gorkaftv1/TFT-CAN-BLE-system/documentation/03_Resumen.tex

{\setlength{\parskip}{8mm}
{\huge{\textbf{Resumen}}}

    {\large{El presente Trabajo de Fin de Título aborda el diseño y desarrollo de un sistema de diagnóstico para vehículos basado en el bus CAN con acceso inalámbrico. Sobre una Raspberry Pi se implementa la pila de protocolos de diagnóstico del automóvil (ISO-TP, OBD-II y UDS), que permite consultar el estado del vehículo y sus códigos de avería en tiempo real. Esta sesión de diagnóstico se expone de forma inalámbrica mediante Bluetooth Low Energy, de modo que pueda monitorizarse desde una aplicación móvil multiplataforma, con persistencia de las sesiones para su análisis posterior. Con el fin de validar la solución de forma independiente del vehículo, se desarrolló además un simulador de unidad de control electrónica (ECU) sobre Arduino que reproduce el comportamiento de una centralita real. El sistema se verificó primero sobre este banco de pruebas y, posteriormente, sobre vehículos reales de distintos fabricantes, contrastando sus resultados con una herramienta de diagnóstico comercial. El trabajo demuestra la viabilidad de construir desde cero una herramienta de diagnóstico portable, de bajo coste y extensible, con un enfoque formativo orientado a la comprensión profunda de los protocolos de comunicación del automóvil.}}

\newpage

{\huge{\textbf{Abstract}}}

    {\large{This Final Degree Project addresses the design and development of a CAN-bus--based vehicle diagnostics system with wireless access. On a Raspberry Pi it implements the automotive diagnostics protocol stack (ISO-TP, OBD-II and UDS), enabling real-time access to the vehicle's status and its diagnostic trouble codes. This diagnostic session is exposed wirelessly over Bluetooth Low Energy so that it can be monitored from a cross-platform mobile application, with session persistence for later analysis. To validate the solution independently of the vehicle, an Electronic Control Unit (ECU) simulator was also developed on Arduino, reproducing the behaviour of a real control unit. The system was first verified on this test bench and later on real vehicles from different manufacturers, comparing its results against a commercial diagnostic tool. The work demonstrates the feasibility of building a portable, low-cost and extensible diagnostic tool from scratch, with an educational focus aimed at a deep understanding of vehicle communication protocols.}

}}
