gorkaftv1/TFT-CAN-BLE-system/documentation/07_Metodologia.tex

\section{Metodología de desarrollo}

El desarrollo de este trabajo se ha llevado a cabo siguiendo la metodología basada en la construcción iterativa de prototipos. Se seleccionó esta metodología dada la dinámica explorativa del proyecto.

La metodología basada en prototipos se estructura en cuatro fases principales: análisis de requisitos, diseño rápido y construcción del prototipo inicial, evaluación y refinamiento iterativo, junto con la documentación más la posterior presentación. Estas fases no son estrictamente secuenciales sino que admiten solapamiento parcial: en particular, las fases de construcción y evaluación se ejecutaron de forma alternada durante la mayor parte del desarrollo, con ciclos cortos de implementación seguidos de pruebas sobre el banco de ensayo Arduino.

\section{Fases y tareas}

\subsection{Fase 1 — Análisis de requisitos \textnormal{(50 horas estimadas)}}

Esta fase inicial se dedicó al estudio de los fundamentos técnicos necesarios para abordar el desarrollo del sistema.

\textbf{Tarea 1.1 — Estudio de la plataforma hardware.} Se analizaron las características de la Raspberry Pi como plataforma de ejecución de la herramienta de diagnóstico, incluyendo el soporte de la interfaz SocketCAN en Linux, la compatibilidad con el controlador CAN MCP2515 y las opciones disponibles para el servidor BLE. Asimismo, se evaluó el Arduino MKR como plataforma del simulador, estudiando la librería CAN disponible y sus capacidades de temporización.

\textbf{Tarea 1.2 — Estudio de los protocolos de comunicación CAN.} Se realizó un análisis detallado de los estándares ISO 11898 (CAN)~\cite{ISO11898-1:2024}, ISO 15765-2 (ISO-TP)~\cite{ISO15765-2:2016} y SAE J1979 (OBD-II)~\cite{SAEJ1979:2014}, prestando especial atención a la estructura de las tramas, los mecanismos de control de flujo y el formato de codificación de cada parámetro. Se revisaron asimismo los conceptos fundamentales de UDS (ISO 14229-1)~\cite{ISO14229-1:2020} y sus servicios más relevantes para la implementación también de las respuestas negativas.

\textbf{Tarea 1.3 — Estudio de Bluetooth Low Energy y librerías disponibles.} Se estudiaron los conceptos fundamentales de BLE GATT, el servicio Nordic UART Service (NUS) y las opciones de implementación disponibles en Python para la Raspberry Pi, evaluando las librerías \texttt{bleak}~\cite{Bleak_lib} y \texttt{bless}~\cite{Bless_lib}. En el lado de la aplicación móvil, se analizó la librería \texttt{react-native-ble-plx}~\cite{ReactNativeBLEPLX} y su compatibilidad con las características de escritura y notificación del servicio NUS.

\textbf{Tarea 1.4 — Análisis de herramientas software.} Se definió el conjunto de herramientas de desarrollo a utilizar: Python 3 con las librerías \texttt{python-can}~\cite{Twiss23-pythoncan} y \texttt{can-isotp}~\cite{Menager23-isotp} para la capa de transporte CAN, SQLite para la persistencia de datos, React Native con Expo~\cite{Expo_docs} para la aplicación móvil, y el IDE de Arduino~\cite{Arduino_IDE} para el simulador. Se estableció asimismo la estructura del repositorio y el flujo de trabajo con control de versiones Git usando ramas independientes por cada uno de los tres elementos del proyecto. El código fuente completo se aloja en el repositorio Git del Instituto Universitario SIANI de la ULPGC~\cite{SIANI_Git}.

\subsection{Fase 2 — Diseño rápido y construcción \textnormal{(75 horas estimadas)}}

\textbf{Tarea 2.1 — Diseño de la arquitectura del sistema.} Se definió la arquitectura general del sistema en tres capas: simulador Arduino, herramienta de diagnóstico en Python y aplicación móvil. Para la herramienta Python se diseñó una arquitectura modular basada en interfaces abstractas (\texttt{ITransport}, \texttt{IProtocolBuilder}, \texttt{IDataDecoder}, \texttt{IDiagnosticSession}), con inyección de dependencias para facilitar las pruebas. Se definieron asimismo el esquema de la base de datos SQLite y el protocolo de comandos JSON utilizado sobre BLE.

\textbf{Tarea 2.2 — Implementación del primer prototipo funcional.} Se desarrolló una primera versión operativa del sistema que incluía: el simulador Arduino respondiendo a peticiones OBD-II básicas en modo 0x01 de lectura de datos en tiempo real (RPM, temperatura de refrigerante, velocidad), la herramienta Python con transporte ISO-TP funcional y sesión de diagnóstico básica.

\subsection{Fase 3 — Evaluación, refinamiento e implementación \textnormal{(125 horas estimadas)}}

Esta fue la fase de mayor duración e intensidad técnica, en la que el prototipo inicial evolucionó de forma iterativa hasta el sistema final.

\textbf{Tarea 3.1 — Extensión del simulador Arduino.} Se amplió el simulador con soporte completo para los cuatro modos OBD-II (modos 0x01 lectura de datos en tiempo real, 0x03 lectura de DTC almacenadas, 0x04 borrado de DTCs (\textit{Diagnostic Trouble Code}) almacenadas y 0x09 lectura de información del vehiculo) y los servicios UDS DiagnosticSessionControl (0x10) y ReadDataByIdentifier (0x22), implementando la respuesta VIN mediante la secuencia ISO-TP multi-frame (FF \textit{First Frame} + CF \textit{Consecutive Frame}). Se añadió el modelo físico de simulación del motor, con la lógica de aceleración, velocidad, temperaturas y consumo de combustible. Posteriormente se incorporaron los mecanismos opcionales de variabilidad del bus (ruido en los sensores y tramas de difusión) y la interrupción hardware para la inyección secuencial de DTCs.

\textbf{Tarea 3.2 — Extensión de la herramienta Python.} Se completó la herramienta con el módulo de logging en SQLite, el decorador \texttt{LoggingTransport}, el monitor de datos en tiempo real con hilo dedicado, la sesión de diagnóstico extendida (\texttt{LoggedDiagnosticSession}) y el servidor BLE GATT con el manejador de comandos JSON (\texttt{BtCommandHandler}).

\textbf{Tarea 3.3 — Desarrollo completo de la aplicación móvil.} Se comenzó el desarrollo completo de la aplicación móvil, implementando cinco pantallas de la aplicación (Panel, Averías, Sesiones, Consola y Ajustes), incluida la pestaña UDS y el flujo de conexión mostrado en dialogos modales (cuadros de diálogo emergentes que requieren interacción del usuario antes de continuar), los almacenes de estado con Zustand~\cite{Zustand_lib} (librería de gestión de estado ligera para React), el adaptador BLE con gestión de timeout y reconexión, y el adaptador simulado (\texttt{MockAdapter}) para el desarrollo sin hardware.

\textbf{Tarea 3.4 — Pruebas de integración.} Se realizaron pruebas del sistema completo sobre el banco de ensayo, verificando el comportamiento ante los escenarios de variabilidad del bus configurables en el simulador, la correcta persistencia de los datos en SQLite y la estabilidad de la conexión BLE durante sesiones de monitorización prolongadas. Finalmente, el sistema se validó sobre un vehículo real (Škoda Yeti 2015).

\subsection{Fase 4 — Documentación y presentación \textnormal{(50 horas estimadas)}}

\textbf{Tarea 4.1 — Redacción de la memoria.} Redacción del presente documento, incluyendo la elaboración de las tablas y figuras de los protocolos de comunicación.

\section{Desviaciones respecto a la planificación inicial}

La planificación inicial contemplaba una distribución de 300 horas totales, con especial peso en la fase de evaluación e implementación (125 horas). En líneas generales, esta estimación resultó ajustada a la realidad del desarrollo, si bien se produjeron algunas desviaciones significativas que conviene señalar.

Por otra parte, la incorporación de los mecanismos opcionales de variabilidad del bus en el simulador no estaba prevista en la planificación original, pero se identificó como útil durante las primeras pruebas de integración. En cuanto a la validación sobre vehículo real, el vehículo objetivo inicial (SEAT Ibiza 6J) no pudo emplearse por problemas de acceso dado que la plataforma del modelo que se había planteado no implementa el protocolo OBD-II sobre el bus CAN en los pines 6 y 14 sino que lo implementa en la antigua línea k-line, por lo que finalmente se llevó a cabo sobre un Škoda Yeti de 2015, también del grupo VAG.

La decisión de estructurar el código Python con una arquitectura de interfaces y capas desacopladas supuso una inversión inicial de tiempo superior a la contemplada en el diseño rápido, pero resultó una buena práctica que se aprovechó en las fases posteriores puesto que facilitó considerablemente la extensión del sistema y la realización de pruebas con el transporte simulado.
