gorkaftv1/TFT-CAN-BLE-system/documentation/main.tex

\documentclass[oneside,12pt]{book}
\usepackage[utf8]{inputenc}
\usepackage{standalone}
\usepackage[margin=2.5cm]{geometry}
\usepackage{graphicx}
\usepackage{hyperref}
\usepackage{lmodern}
\usepackage[T1]{fontenc}
\usepackage{float}
\usepackage[spanish,es-noshorthands]{babel}
\usepackage{csquotes}
\usepackage[figurename=Figura]{caption}
\usepackage{subcaption}
\usepackage[numbers]{natbib}
\usepackage{ragged2e}
\usepackage{array}
\usepackage{multirow}
\usepackage{makecell}
\usepackage{longtable}
\usepackage{parskip}
\usepackage{listings}
\usepackage{epigraph}
\usepackage{lipsum}

\usepackage{algorithm}
\usepackage{algpseudocode}

\usepackage{glossaries}

\makeglossaries

\newglossaryentry{latex}
{
    name=latex,
    description={Is a markup language specially suited for scientific documents}
}

\newglossaryentry{maths}
{
    name=mathematics,
    description={Mathematics is what mathematicians do}
}
% Glosario de términos - END

%\usepackage{fancyhdr}
\usepackage{geometry}
\usepackage{color}\usepackage{graphicx,xcolor}

\renewcommand{\lstlistingname}{Listado}

% El texto referencia las tablas como "Tabla"; babel-spanish las rotula "Cuadro".
% Se fuerza "Tabla" tanto en el rótulo del caption como en el índice de tablas.
\captionsetup[table]{name=Tabla}
\addto\captionsspanish{\renewcommand{\listtablename}{Índice de tablas}}

\floatname{algorithm}{Algoritmo}
\renewcommand{\listalgorithmname}{Índice de algoritmos}

\lstset{
    basicstyle=\fontsize{7.5}{11}\ttfamily,
    captionpos=b,
    frame=single,
    breaklines=true,
    breakatwhitespace=false,
    columns=flexible,
    postbreak=\mbox{$\hookrightarrow$\space},
    numbers=left,
    numberstyle=\tiny\color{gray},
    numbersep=5pt,
    showstringspaces=false,
    keywordstyle=\bfseries,
    commentstyle=\color{gray}\itshape,
    stringstyle=\color{black},
    extendedchars=true,
    literate=%
      {á}{{\'a}}1 {é}{{\'e}}1 {í}{{\'i}}1 {ó}{{\'o}}1 {ú}{{\'u}}1
      {Á}{{\'A}}1 {É}{{\'E}}1 {Í}{{\'I}}1 {Ó}{{\'O}}1 {Ú}{{\'U}}1
      {ñ}{{\~n}}1 {Ñ}{{\~N}}1 {ü}{{\"u}}1
      {¿}{{\textquestiondown}}1 {¡}{{\textexclamdown}}1
      {°}{{\textdegree}}1 {—}{{---}}1 {–}{{--}}1,
}

\lstdefinelanguage{JavaScript}{
    keywords={const,let,var,function,async,await,return,new,this,if,else,
              for,of,in,try,catch,throw,class,extends,export,import,from,
              private,public,static,interface,type,null,undefined,true,false},
    morestring=[b]',
    morestring=[b]",
    morestring=[b]`,
    morecomment=[l]{//},
    morecomment=[s]{/*}{*/},
    sensitive=true,
}

\usepackage{titlesec}
\setcounter{secnumdepth}{3}
\titleformat{\chapter}[display]
{\normalfont\huge\bfseries}{\chaptertitlename\ \thechapter}{20pt}{\Huge}

% Permite a TeX estirar líneas difíciles (código inline, URLs) evitando que
% el texto invada el margen derecho (Overfull \hbox).
\setlength{\emergencystretch}{3em}

\urlstyle{same}
\title{Diseño y desarrollo de un sistema empotrado basado en bus CAN con acceso inalámbrico para la monitorización de un vehículo automóvil}
\author{Gorka Eymard Santana Cabrera}
\date{Curso 2025 - 2026}
\renewcommand{\contentsname}{Contenido}
\renewcommand{\figurename}{Figura}
\usepackage{pifont}
\renewcommand\labelitemi{\textbullet}

\begin{document}
%\maketittle
\input{00_Portada.tex}

\input{01_TFT04C.tex}

\newpage
\pagenumbering{roman}
{\Large{\textbf{Agradecimientos}}}
\input{02_Agradecimientos.tex}

\clearpage
\input{03_Resumen.tex}
\tableofcontents

\addcontentsline{toc}{section}{Listings}
\lstlistoflistings
\listofalgorithms

\listoffigures

\listoftables

\clearpage
\pagenumbering{arabic}

\chapter{Introducción}
En este capítulo se realizará una introducción general al contexto del sector automotriz en el que se plantea el trabajo realizado y el motivo de por qué se ha realizado este trabajo.
\input{04_Introduccion.tex}

\chapter{Estado actual y objetivos}
Este capítulo expone los protocolos (CAN, OBD-II, ISO-TP, UDS) y herramientas tanto software como hardware (Raspberry Pi) que se usan en el marco en el que se encuentra el trabajo a desarrollar, así como los objetivos definidos para la realización del mismo.
\input{05_EstadoDelArte.tex}

\chapter{Aportaciones del trabajo}
En este capítulo se presentan las aportaciones de este trabajo así como las competencias y ODS que sigue.
\chaptermark{Aportaciones, competencias y ODS}
\input{06_Competencias.tex}

\chapter{Metodología de desarrollo}
En este capítulo se detalla lo conseguido durante las distintas etapas del desarrollo detallando el análisis y diseños llevados a cabo.
\input{07_Metodologia.tex}

\chapter{Desarrollo del sistema}
\input{08_Desarrollo.tex}

\chapter{Resultados}
En este capítulo se estudian los resultados obtenidos, realizando una comparación con una herramienta comercial que nos ofrece la realización de escaneo.
\input{09_Resultados.tex}

\chapter{Conclusiones y trabajo futuro}
\input{10_Conclusiones.tex}

\appendix
\renewcommand{\appendixname}{Anexo}
% Anexos de código (A-D) desactivados temporalmente para aligerar la memoria.
% El código completo está en el repositorio del proyecto.
% \input{anexos/AnexoA_CodigoArduino.tex}
% \input{anexos/AnexoB_CodigoPython.tex}
% \input{anexos/AnexoC_CodigoApp.tex}
% \input{anexos/AnexoD_BaseDatos.tex}
\input{anexos/AnexoE_PIDs.tex}
\input{anexos/AnexoF_ComandosBLE.tex}

\clearpage

\bibliographystyle{unsrtnat}
\bibliography{ref}

\printglossaries

\end{document}
