gorkaftv1/TFT-CAN-BLE-system/documentation/01_TFT04C.tex

\newgeometry{margin=1.5cm}

\thispagestyle{empty}

%\lhead{ 
\begin{tabular}{p{15cm}p{5cm}}
  %\includegraphics{Ilustraciones/LogoEII.jpg}   &  TFT04\\
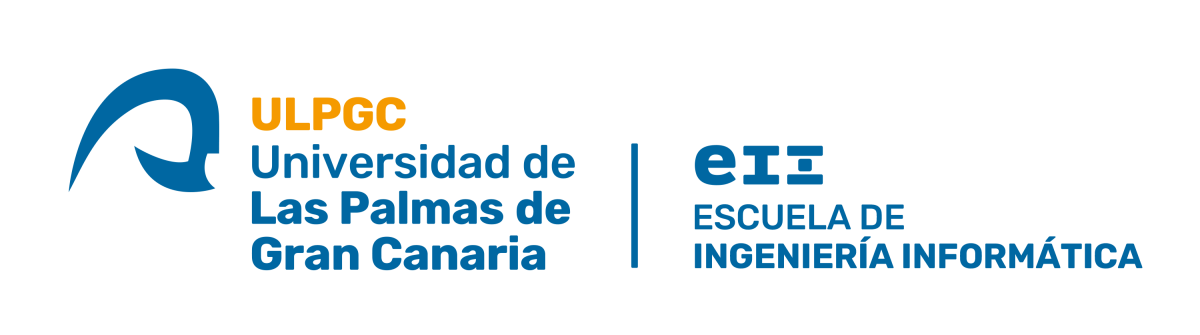
[picture p36: documentation/Ilustraciones/NuevoLogoEII.png]
     &  TFT04\\
\end{tabular}
%}

\vspace{1em}
\fboxrule=2pt
\begin{center}
\fcolorbox{gray}{gray!10}{\parbox{.8 \textwidth}{ {\large SOLICITUD DE DEFENSA DE TRABAJO DE FIN DE TÍTULO}}}
\end{center}

\vspace{1em}
\justify
D./Dª Gorka Eymard Santana Cabrera, autor del trabajo Diseño y desarrollo de un sistema empotrado basado en bus CAN con acceso inalámbrico para la monitorización de un vehículo automóvil, correspondiente a la titulación Grado de Ingeniería Informática.

\vspace{1em}
SOLICITA

\vspace{1em}
que se inicie el procedimiento de defensa del mismo, para lo que se adjunta la documentación requerida, haciendo constar que 

[x] se autoriza / [ ] no se autoriza la grabación en audio de la exposición y turno de preguntas.

\vspace{1em}
Asimismo, con respecto al registro de la propiedad intelectual/industrial del TFT, declara que:

[ ] Se ha iniciado o hay intención de iniciarlo (defensa no pública).

[ ] No está previsto.

\vspace{1em}
Y para que así conste firma la presente. (fecha en firma electrónica)

\begin{center}
%En Las Palmas de Gran Canaria, a día de mes de año

\vspace{1em}
El/La estudiante

\vspace{3em}
Fdo.------------------------
\end{center}

\begin{center}
\fcolorbox{gray}{white!10}{\parbox{.9\textwidth}{
{\tiny A rellenar y firmar \textbf{obligatoriamente} por el/la/los/las tutores}

En relación con la presente solicitud, se informa:{\tiny (firmar donde corresponda)}

\vspace{1em}
\begin{center}
\begin{tabular}{|p{\dimexpr.45\linewidth}|p{\dimexpr.45\linewidth}|}
%\begin{tabular}{|l|r|}
    \hline
   & \\
  Positivamente {\tiny (en  caso  de  detección  de  copia, esta firma quedará invalidada)}  & Negativamente {\tiny (justificación en TFT05)} \\
   & \\
   & \\
   & \\
   & \\
   & \\
   & \\
  Fdo.------------------------ & Fdo.------------------------  \\
     & \\

    \hline
\end{tabular} 

\end{center}

\vspace{1em}

}
}

\vspace{1em}

%\cfoot{
DIRECTOR DE LA ESCUELA DE INGENIERÍA INFORMÁTICA
%}

\end{center}

\restoregeometry

\clearpage
