gorkaftv1/TFT-CAN-BLE-system/documentation/Agradecimientos.tex

\begin{flushleft}
La realización de este Trabajo de Fin de Título no habría sido posible sin el apoyo y la colaboración de diversas personas e instituciones a las que deseo expresar mi más sincero agradecimiento.

En primer lugar, quiero agradecer a los profesores Antonio C.\ Domínguez Brito y Jorge Cabrera Gámez, por su dedicación, orientación y apoyo durante el desarrollo de este trabajo. Su experiencia y los consejos recibidos han sido fundamentales para encauzar el desarrollo de este proyecto en la dirección correcta.

Asimismo, agradezco al profesor Jorge Cabrera Gámez, tutor colaborador, su implicación y el valioso apoyo técnico aportado durante las distintas fases del trabajo. Sus indicaciones han contribuido de manera significativa a la calidad del resultado final.

De igual modo, deseo expresar mi gratitud a la División de Robótica y Oceanografía Computacional del Instituto Universitario SIANI de la Universidad de Las Palmas de Gran Canaria, por poner a disposición de este proyecto los medios materiales y el equipamiento necesarios para llevar a cabo el desarrollo experimental y las pruebas del sistema.

Por último, agradezco a todas las personas que, de una forma u otra, han brindado su apoyo durante este período, haciendo posible la culminación de este trabajo.
\end{flushleft}
