gorkaftv1/TFT-CAN-BLE-system/documentation/Anexos.tex

\section{Ejemplos de capítulos opcionales}

Dependiendo del tipo de trabajo, se podrían incluir, en el orden que corresponda, capítulos adicionales como los siguientes:

\begin{description}
\item{REQUISITOS}
\item{NORMATIVA Y LEGISLACIÓN} incluir la legislación vigente que afecte al TFT (ley de protección de datos, leyes sobre seguridad, ...)
\item{ASPECTOS ECONÓMICOS Y TEMPORALES}
\item{DISEÑO}
\item{RESULTADOS EXPERIMENTALES}
\item{MANUAL  DE  USUARIO  Y  SOFTWARE}  deberán  incluirse  obligatoriamente  en  la  memoria  los extractos más relevantes   del código desarrollado. Siempre que sea posible, deberá   proporcionarse acceso a un repositorio software.
\end{description}
