gorkaftv1/TFT-CAN-BLE-system/documentation/Conclusiones.tex

\section{Conclusiones}

Valoración de resultados, grado de consecución de los  objetivos.

\section{Trabajo futuro}

Líneas de trabajo futuro, aspectos pendientes, posibles extensiones.

\section{Uso de la IA}

Indicar el uso que se ha hecho de la IA tanto en la elaboración de este documento como en el desarrollo del TFG.

\vspace{1cm}

\textbf{EXTENSIÓN DE LA MEMORIA:}

\begin{itemize}
    \item GII, GIFM, DGII-ADE (parte de GII): entre 50 y 100 páginas
    \item GCID: entre 75 y 100 páginas
\end{itemize}
