gorkaftv1/TFT-CAN-BLE-system/documentation/EstadoDelArte.tex

\section{Motivación y antecedentes}

La motivación para el desarrollo de este trabajo surge de la curiosidad por estudiar la serie de protocolos que se usan en el sector automovilistico donde se trabaja en un entorno de comunicaciónes críticas y ruidosas, donde se requiere una alta fidelidad en la transmisión de datos.\\

\section{Objetivos}

El objetivo del desarrollo de este proyecto, es diseñar y desarrollar un sistema empotrado basado en bus CAN con acceso inalámbrico para la monitorización de un vehículo automóvil perteneciente al grupo de automoción VAG. Con el fin de tener una herramienta de monitorización y evaluación de los parámetros del vehiculo, que permita el acceso a los datos de forma inalámbrica, y que pueda ser utilizada para la mejora del rendimiento del vehículo, la detección de fallos y el mantenimiento predictivo.
