gorkaftv1/TFT-CAN-BLE-system/documentation/figuras/fig_can_frame.tex

\centering
\renewcommand{\arraystretch}{1.4}

% Tabla 1: Arbitration + Control
\begin{tabular}{|c|c|c|c|c|c|}
\hline
\makecell{\textbf{SOF} \\ \scriptsize{Start Of Frame}} &
\makecell{\textbf{ID} \\ \scriptsize{Identificador}} &
\makecell{\textbf{RTR} \\ \scriptsize{Remote Transmission Request}} &
\makecell{\textbf{IDE} \\ \scriptsize{ID Extension}} &
\makecell{\textbf{r0} \\ \scriptsize{Reservado}} &
\makecell{\textbf{DLC} \\ \scriptsize{Data Length Code}} \\
\hline
1 bit & 11 bits & 1 bit & 1 bit & 1 bit & 4 bits \\
\hline
\multicolumn{5}{|c|}{\textit{Arbitration + Control}} & \\
\hline
\end{tabular}

\vspace{0.5cm}

% Tabla 2: Datos, CRC, ACK, EOF
\begin{tabular}{|c|c|c|c|c|c|}
\hline
\makecell{\textbf{DATA} \\ \scriptsize{Datos}} &
\makecell{\textbf{CRC} \\ \scriptsize{Cyclic Redundancy Check}} &
\makecell{\textbf{CD} \\ \scriptsize{CRC Delimiter}} &
\makecell{\textbf{ACK} \\ \scriptsize{Acknowledgement}} &
\makecell{\textbf{AD} \\ \scriptsize{ACK Delimiter}} &
\makecell{\textbf{EOF} \\ \scriptsize{End Of Frame}} \\
\hline
0--64 bits & 15 bits & 1 bit & 1 bit & 1 bit & 7 bits \\
\hline
\textit{Datos} & \multicolumn{2}{c|}{\textit{CRC}} & \multicolumn{2}{c|}{\textit{ACK}} & \textit{EOF} \\
\hline
\end{tabular}
