gorkaftv1/TFT-CAN-BLE-system/documentation/anexos/AnexoE_PIDs.tex

\chapter{Tabla completa de PIDs OBD-II Modo 0x01}
\label{anx:obd2_pids_full}

La siguiente tabla recoge todos los PIDs definidos por SAE~J1979~\cite{SAEJ1979:2014} para el Modo 0x01 (\textit{Show current data}). Los PIDs marcados con~(*) son obligatorios para todo vehículo OBD-II conforme; el resto son opcionales y su soporte depende del fabricante y modelo. Las letras A, B, C, D denotan los bytes de la respuesta en orden (primero~=~A).

\input{figuras/fig_obd2_pids.tex}
