gorkaftv1/TFT-CAN-BLE-system/documentation/figuras/fig_ods_table.tex

\centering
\renewcommand{\arraystretch}{1.2}
\begin{tabular}{|l|c|c|c|c|}
\cline{1-5}
 & \multicolumn{4}{c|}{Grado de relación} \\ \cline{2-5}
\textbf{ODS} & \textbf{0} & \textbf{1} & \textbf{2} & \textbf{3} \\
 & No procede & Bajo & Medio & Alto \\ \cline{1-5}
1\quad Fin de la Pobreza              & X & & & \\ \cline{1-5}
2\quad Hambre Cero                    & X & & & \\ \cline{1-5}
3\quad Salud y Bienestar              & X & & & \\ \cline{1-5}
4\quad Educación de Calidad           & & & X & \\ \cline{1-5}
5\quad Igualdad de Género             & X & & & \\ \cline{1-5}
6\quad Agua Limpia y Saneamiento      & X & & & \\ \cline{1-5}
7\quad Energía Asequible y No Contaminante & X & & & \\ \cline{1-5}
8\quad Trabajo Decente y Crecimiento Económico & & X & & \\ \cline{1-5}
9\quad Industria, Innovación e Infraestructuras & & & X & \\ \cline{1-5}
10\quad Reducción de las Desigualdades & X & & & \\ \cline{1-5}
11\quad Ciudades y Comunidades Sostenibles & X & & & \\ \cline{1-5}
12\quad Producción y Consumo Responsables & & X & & \\ \cline{1-5}
13\quad Acción por el Clima           & X & & & \\ \cline{1-5}
14\quad Vida Submarina                & X & & & \\ \cline{1-5}
15\quad Vida de Ecosistemas Terrestres & X & & & \\ \cline{1-5}
16\quad Paz, Justicia e Instituciones Sólidas & X & & & \\ \cline{1-5}
17\quad Alianzas para Lograr los Objetivos & X & & & \\ \cline{1-5}
\end{tabular}
