gorkaftv1/TFT-CAN-BLE-system/documentation/Ilustraciones/app_panel.jpg

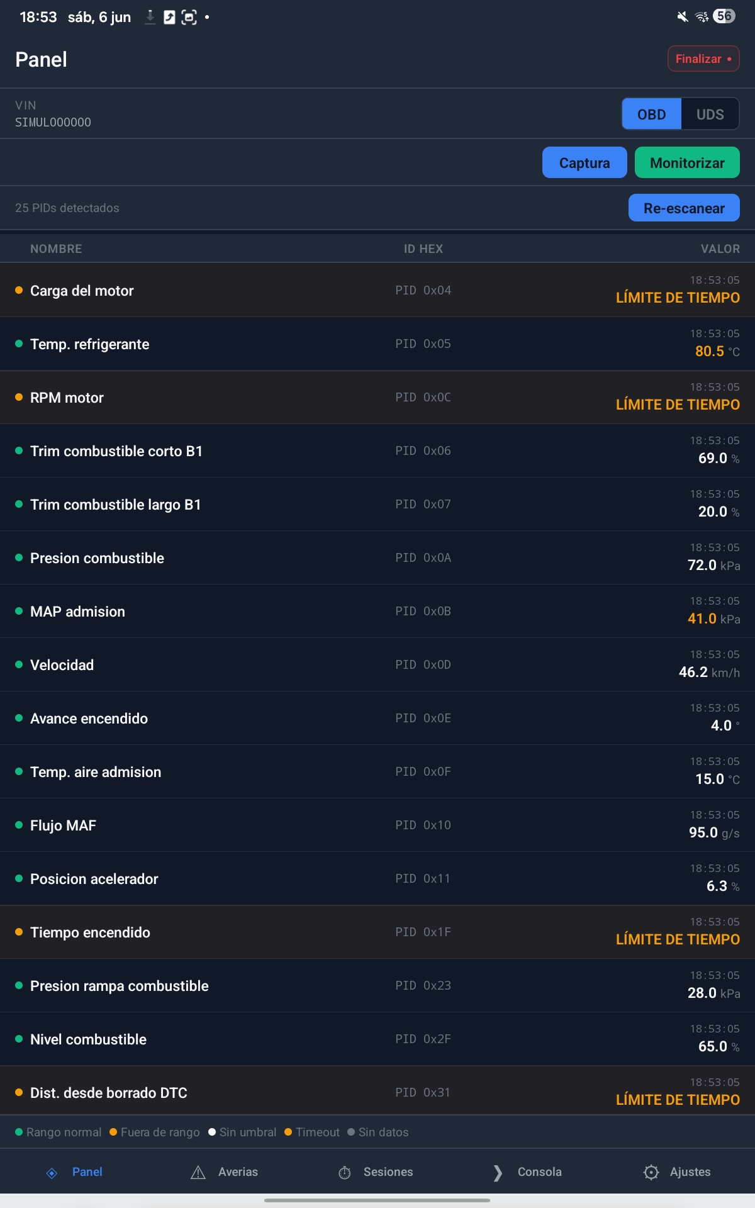
documentation/Ilustraciones/app_panel.jpg
