gorkaftv1/TFT-CAN-BLE-system/documentation/Ilustraciones/opel_panel_uds.png

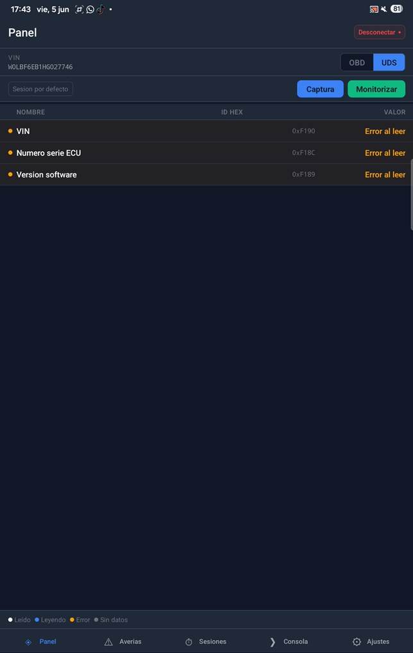
documentation/Ilustraciones/opel_panel_uds.png
