gorkaftv1/TFT-CAN-BLE-system/documentation/09_Resultados.tex

% TODO - revisar y redactar todo el capítulo
\section{Resultados obtenidos}
\label{sec:resultados}

Este capítulo presenta los resultados de la validación del sistema en dos entornos complementarios: el banco de ensayo Arduino, que permitió reproducir condiciones adversas de forma controlada, y un vehículo real, en el que se verificó la interoperabilidad del sistema con una ECU de producción a través del conector OBD-II estándar. Los resultados se organizan en torno a cuatro dimensiones: funcionalidad del protocolo, rendimiento de la comunicación, comportamiento ante condiciones adversas y grado de consecución de los objetivos planteados en el Capítulo~2.

Para verificar que los resultados obtenidos por la herramienta desarrollada son verídicos, previamente se realizó un escaneo de los DTCs y una lectura de PIDs con una herramienta comercial genérica KONWEII~\cite{KONWEII_scanner} junto con la aplicación móvil Car Scanner ELM OBD2~\cite{CarScanner_app}, tomada como referencia. La Figura~\ref{fig:ref_comercial} muestra el cuadro de instrumentos y la lista de DTCs obtenidos con la herramienta de referencia, que sirvieron de patrón de comparación para validar los valores leídos por la herramienta desarrollada.

\begin{figure}[H]
\centering
\begin{minipage}[t]{0.42\textwidth}
\centering
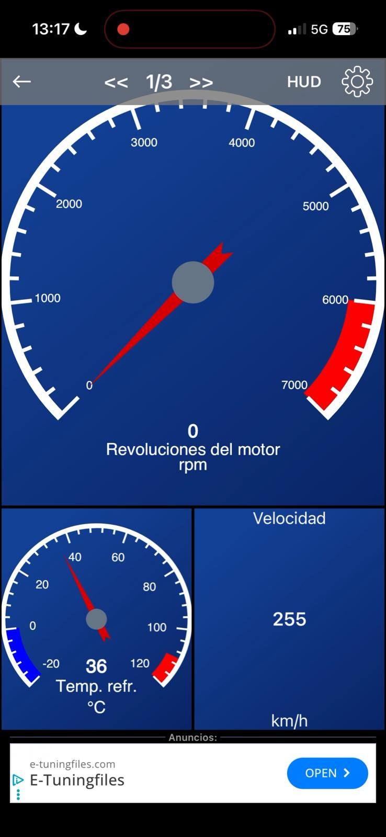
[picture p39: documentation/Ilustraciones/cuadro_konwei.png]

\subcaption{Cuadro de instrumentos (lectura de PIDs).}
\label{fig:ref_panel}
\end{minipage}\hfill
\begin{minipage}[t]{0.42\textwidth}
\centering
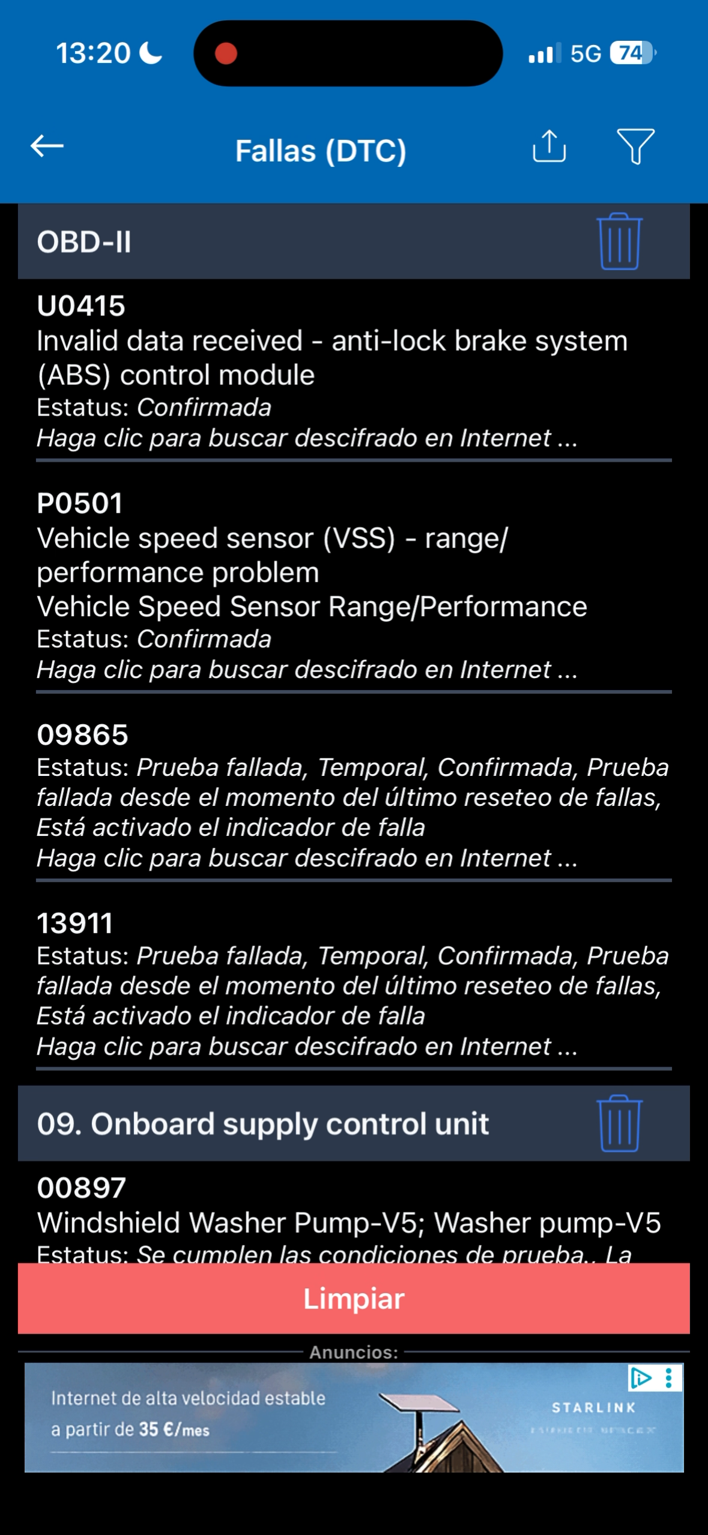
[picture p40: documentation/Ilustraciones/dtc_konwei.PNG]

\subcaption{Lista de DTCs.}
\label{fig:ref_dtcs}
\end{minipage}
\caption{Herramienta comercial de referencia (Car Scanner ELM OBD2~\cite{CarScanner_app}): cuadro de instrumentos (a) y lista de DTCs (b).}
\label{fig:ref_comercial}
\end{figure}

% NOTA: tab:latencias (latencia extremo-a-extremo) NO puede sacarse de la BD
%   (solo hay wall_ts de finalización por comando, sin timestamps por etapa).
%   Esa tabla requiere instrumentar el código en vivo; sigue marcada con su TODO.
\section{Validación sobre vehículo real}
\label{sec:resultados_vehiculo_real}

Tras completar la validación sobre el banco de ensayo, el sistema se probó sobre un vehículo real. El vehículo objetivo inicial era un SEAT Ibiza 6J, pero debido a que la plataforma de ese modelo no implementa el protocolo OBD-II sobre el bus CAN en los pines 6 y 14 del puerto OBD, la validación final se realizó sobre un \textbf{Škoda Yeti de 2015}, perteneciente igualmente al grupo VAG y, por tanto, representativo de la misma arquitectura de diagnóstico. La conexión se efectuó mediante un cable OBD-II estándar~\cite{YingtuYou_OBD2} (Figura~\ref{fig:cable_obd}) que nos revela todos los pines del puerto de diagnóstico del vehículo: la Raspberry Pi actuó como interfaz entre el bus CAN del vehículo conectado a través de los pines 6 y 14 (\texttt{CAN\_H} y \texttt{CAN\_L} respectivamente) del puerto OBD-II y la aplicación móvil, manteniendo exactamente el mismo stack de software validado en el banco (\texttt{IsoTpTransport} sobre SocketCAN, servidor BLE GATT con NUS y aplicación React Native).

\begin{figure}[H]
\centering
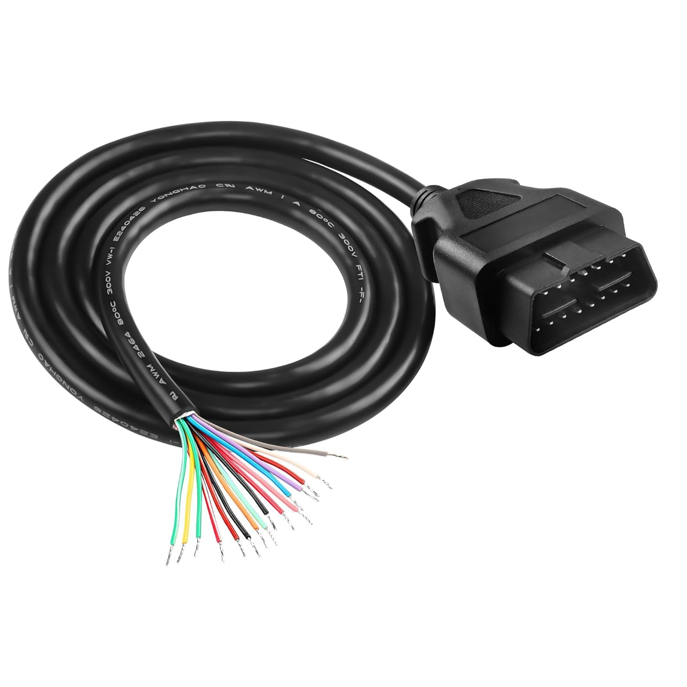
[picture p41: documentation/Ilustraciones/cable_OBD.png]

\caption{Cable OBD-II utilizado para la conexión al puerto de diagnóstico del Škoda Yeti, con los pines expuestos que permiten identificar y conectar directamente \texttt{CAN\_H} (pin~6) y \texttt{CAN\_L} (pin~14).}
\label{fig:cable_obd}
\end{figure}

La conexión al vehículo demostró que el protocolo OBD-II implementado es compatible con ECUs de producción: la herramienta fue capaz de consultar los PIDs del modo 0x01 soportados por el vehículo, leer el VIN real mediante la secuencia ISO-TP multi-frame y recibir datos de telemetría en tiempo real a través de la aplicación móvil. Las respuestas del vehículo presentaron tiempos de respuesta ligeramente superiores a los del simulador (10--30\,ms frente a 2--8\,ms).

\begin{figure}[!htbp]
\centering

\caption{Sistema montado en el vehículo real: cable OBD-II conectado al puerto de diagnóstico, Raspberry Pi.}
\label{fig:vehiculo_real}
\end{figure}

Los datos leídos del Škoda Yeti se almacenaron en la base de datos SQLite como una sesión más, lo que permitió revisar a posteriori la telemetría capturada desde la propia aplicación móvil. La Figura~\ref{fig:skoda_sesion} muestra el detalle de la sesión registrada sobre el vehículo real: la lista de muestras agrupadas por sensor, el detalle de una muestra concreta con su valor decodificado y la lista de DTCs leídos de la ECU del vehículo.

\begin{figure}[H]
\centering
\begin{minipage}[t]{0.48\textwidth}
\centering
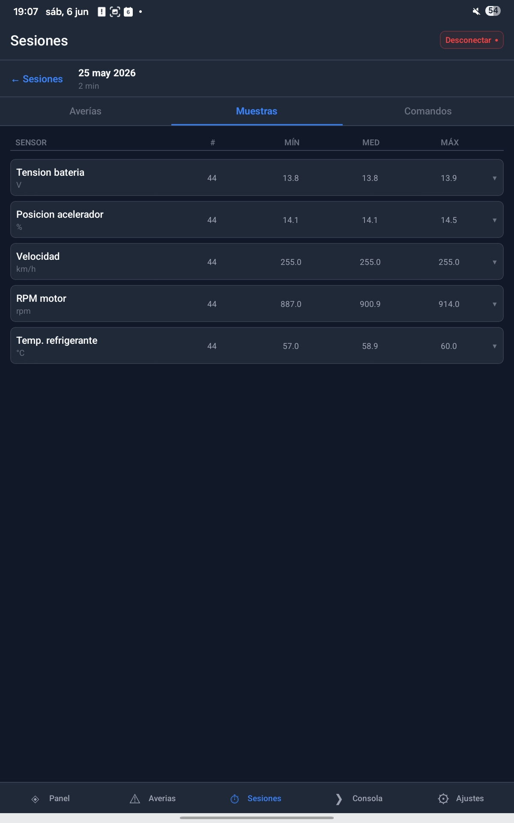
[picture p42: documentation/Ilustraciones/app_session_muestras.jpg]

\subcaption{Muestras de la sesión por sensor.}
\label{fig:skoda_muestras}
\end{minipage}\hfill
\begin{minipage}[t]{0.48\textwidth}
\centering
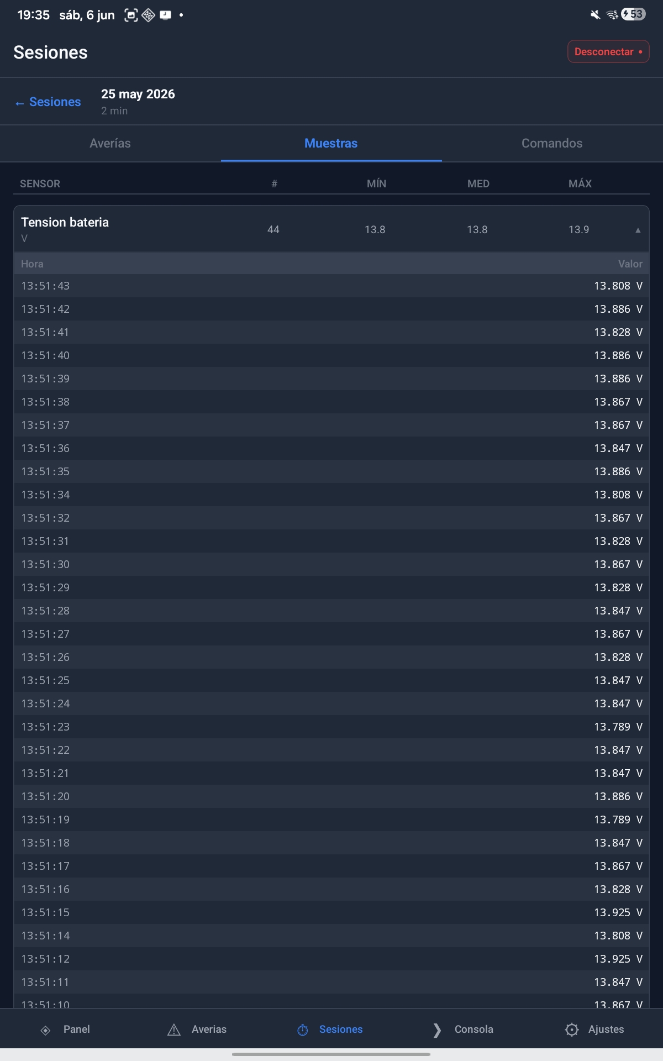
[picture p43: documentation/Ilustraciones/app_session_muestra_detalle.jpg]

\subcaption{Detalle de una muestra.}
\label{fig:skoda_muestra_detalle}
\end{minipage}
\caption{Validación sobre el Škoda Yeti: muestras de telemetría agrupadas por sensor (a) y detalle de una muestra concreta con su valor decodificado (b).}
\label{fig:skoda_sesion}
\end{figure}

\begin{figure}[H]
\centering
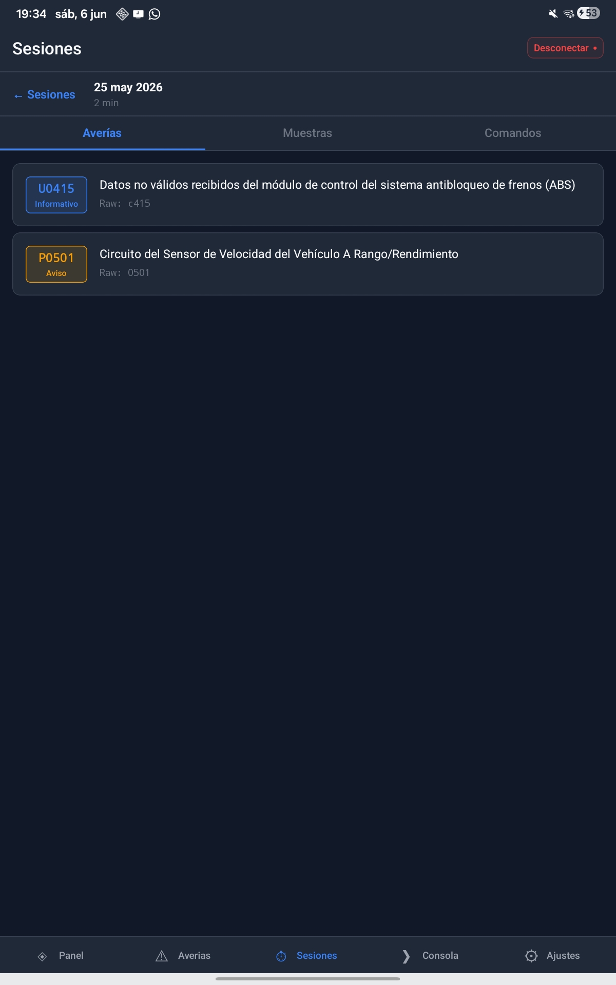
[picture p44: documentation/Ilustraciones/app_session_dtc.jpg]

\caption{Validación sobre el Škoda Yeti: lista de DTCs leídos de la ECU del vehículo.}
\label{fig:skoda_dtc}
\end{figure}

El VIN reconstruido por la herramienta mediante la secuencia ISO-TP multi-frame fue \texttt{TMBJF45LXF6022462} (código de fabricante \texttt{TMB}, correspondiente a Škoda), coincidiendo carácter a carácter con el grabado en el vehículo. La tabla~\ref{tab:skoda_telemetria} compara los rangos de telemetría medidos por la herramienta desarrollada sobre el Škoda Yeti (extraídos de la base de datos SQLite con \texttt{scripts/db\_metrics.py} sobre un total de 1\,627 muestras) con las lecturas obtenidas por la herramienta comercial de referencia (KONWEII junto a Car Scanner ELM OBD2~\cite{KONWEII_scanner, CarScanner_app}) sobre el mismo vehículo.

\begin{table}[!htbp]
\caption{Comparación de la telemetría del Škoda Yeti: herramienta desarrollada (base de datos SQLite) frente a la herramienta comercial de referencia.}
\label{tab:skoda_telemetria}
\centering
\renewcommand{\arraystretch}{1.2}
\resizebox{\textwidth}{!}{%
\begin{tabular}{|c|l|c|c|c|}
\hline
\textbf{PID} & \textbf{Parámetro} & \textbf{Herramienta desarrollada} & \textbf{Herramienta comercial} & \textbf{Coincide} \\
\hline
\texttt{0x0C} & RPM del motor          & 0 -- 3843\,rpm   & 0 -- 3843\,rpm   & Sí \\
\texttt{0x05} & Temp. refrigerante     & 33 -- 72\,°C     & 33 -- 63\,°C     & Sí$^{*}$ \\
\texttt{0x11} & Posición acelerador    & 12,2 -- 86,7\,\% & 12,2 -- 86,7\,\% & Sí \\
\texttt{0x04} & Carga calculada motor  & 0 -- 55,7\,\%    & 0 -- 55,7\,\%    & Sí \\
\texttt{0x0B} & Presión MAP admisión   & 24 -- 107\,kPa   & 24 -- 107\,kPa   & Sí \\
\texttt{0x42} & Tensión de batería     & 10,4 -- 14,1\,V  & 10,4 -- 14,1\,V  & Sí \\
\texttt{0x43} & Carga absoluta         & 19,2 -- 62,4\,\% & 19,2 -- 62,4\,\% & Sí \\
\texttt{0x33} & Presión barométrica    & 101\,kPa         & 106\,kPa         & $\approx$ \\
\texttt{0x0D} & Velocidad              & 255\,km/h (cte.) & 255\,km/h (cte.) & Sí \\
\hline
\end{tabular}%
}

\vspace{2pt}
{\footnotesize $^{*}$ La prueba con la herramienta comercial fue más breve, por lo que el motor alcanzó una temperatura de refrigerante inferior (63\,°C frente a 72\,°C). El rango es coherente en ambos casos.}
\end{table}

Las lecturas de ambas herramientas resultaron equivalentes en la práctica totalidad de los parámetros. Las únicas diferencias fueron la temperatura de refrigerante (consecuencia de la distinta duración de cada prueba) y la presión barométrica (106\,kPa frente a 101\,kPa, una desviación de unos 5\,kPa atribuible a la tolerancia y calibración del sensor). Esta correspondencia confirma la validez de las lecturas de la herramienta desarrollada frente a un instrumento comercial de referencia.

El valor del PID \texttt{0x0D} (velocidad) se mantuvo constante en 255\,km/h (\texttt{0xFF}) durante toda la captura, valor que la herramienta registró fielmente y que se corresponde con una lectura no válida del sensor de velocidad. Este comportamiento es coherente con los DTC almacenados en la ECU del vehículo, leídos por la herramienta y recogidos en la tabla~\ref{tab:skoda_dtcs}: el código \texttt{P0501} (\textit{rango/rendimiento del sensor de velocidad}) explica directamente la lectura anómala, lo que demuestra que la telemetría y el diagnóstico de averías obtenidos por la herramienta son mutuamente consistentes.

\begin{table}[!htbp]
\caption{DTCs reales leídos por la herramienta de la ECU del Škoda Yeti.}
\label{tab:skoda_dtcs}
\centering
\renewcommand{\arraystretch}{1.2}
\begin{tabular}{|c|l|}
\hline
\textbf{Código} & \textbf{Descripción} \\
\hline
\texttt{P0501} & Circuito del sensor de velocidad del vehículo A — rango/rendimiento \\
\texttt{U0415} & Datos no válidos recibidos del módulo de control del ABS \\
\hline
\end{tabular}
\end{table}

Finalmente se realizó una prueba adicional sobre un \textbf{Opel Astra K}, perteneciente al grupo PSA/Opel y, por tanto, a una arquitectura de diagnóstico distinta a la del grupo VAG. Esta prueba corroboró el correcto funcionamiento del protocolo OBD-II: la herramienta consultó sin incidencias los PIDs del modo 0x01 y leyó el VIN del vehículo, confirmando que la capa de diagnóstico estandarizada es interoperable entre fabricantes. Sin embargo, la prueba puso de manifiesto la dificultad de implementar el protocolo UDS de forma genérica, dado que los servicios extendidos (en particular la lectura de datos por identificador, servicio 0x22) se apoyan en \textit{Data Identifiers} (DID) propietarios cuyo significado y disponibilidad varían según el fabricante. Al solicitar los DID validados sobre la plataforma VAG, la ECU del Opel respondió con códigos de respuesta negativa (NRC), confirmando que estos identificadores no están normalizados y que un soporte UDS completo exigiría incorporar la base de datos de DID específica de cada marca. La Figura~\ref{fig:opel_astra} contrasta la lectura de la herramienta de referencia comercial con el panel de telemetría y el escaneo de DTCs obtenidos por la herramienta desarrollada sobre el Opel Astra K.

\begin{figure}[H]
\centering
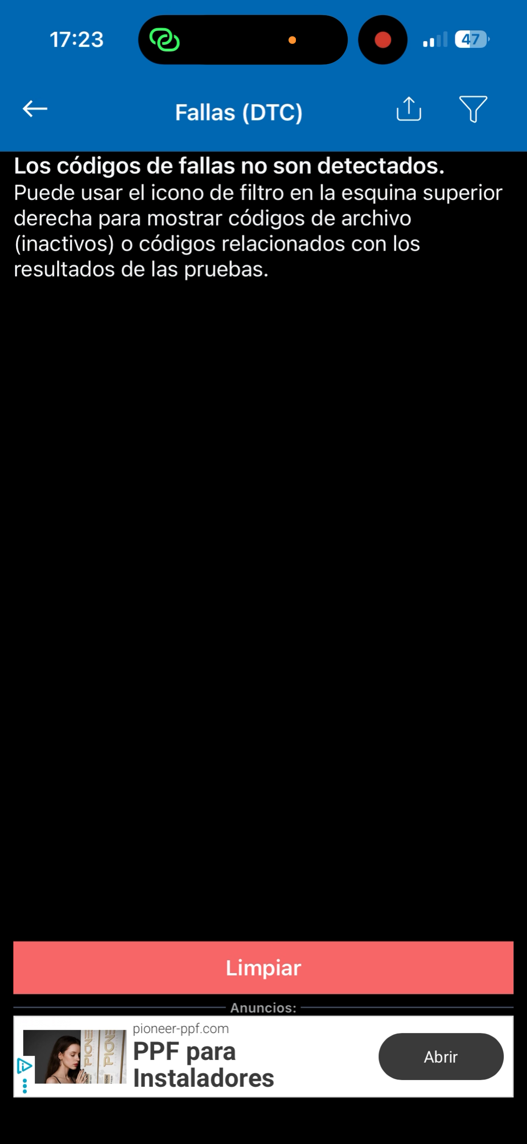
[picture p45: documentation/Ilustraciones/opel_konwei.PNG]

\caption{Herramienta comercial de referencia (Car Scanner ELM OBD2~\cite{CarScanner_app}) sobre el Opel Astra K: no detecta ningún DTC activo.}
\label{fig:opel_konwei}
\end{figure}

\begin{figure}[H]
\centering
\begin{minipage}[t]{0.48\textwidth}
\centering
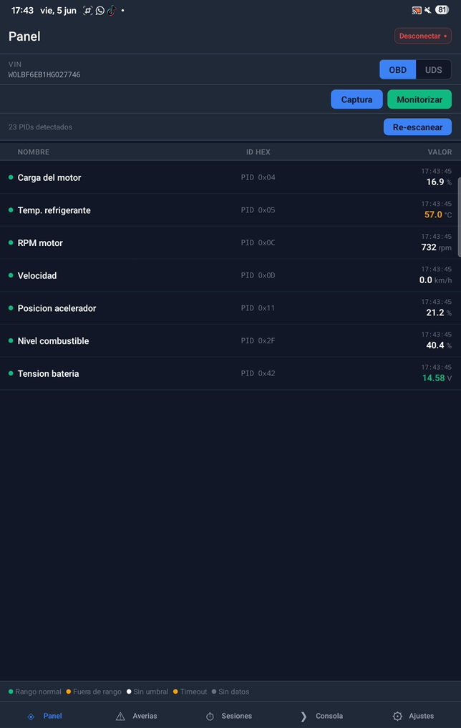
[picture p46: documentation/Ilustraciones/opel_panel.png]

\subcaption{Panel de telemetría.}
\label{fig:opel_panel}
\end{minipage}\hfill
\begin{minipage}[t]{0.48\textwidth}
\centering
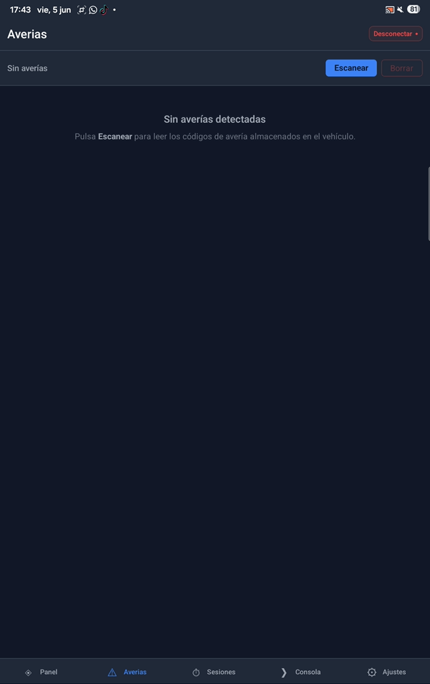
[picture p47: documentation/Ilustraciones/opel_dtc.png]

\subcaption{Escaneo de DTCs.}
\label{fig:opel_dtc}
\end{minipage}
\caption{Herramienta desarrollada sobre el Opel Astra K: panel de telemetría (a) y escaneo de DTCs (b).}
\label{fig:opel_astra}
\end{figure}

\section{Validación funcional del protocolo OBD-II}
\label{sec:resultados_protocolo}

La herramienta de diagnóstico fue capaz de completar satisfactoriamente el ciclo completo de consulta para los 25 PIDs implementados en el modo 0x01, la lectura del VIN del modo 0x09 (mediante la secuencia multi-frame), los modos de gestión de DTCs 0x03 y 0x04, y los servicios UDS 0x10 (DiagnosticSessionControl) y 0x22 (ReadDataByIdentifier).

La tabla~\ref{tab:pids_validados} resume los parámetros validados más representativos, indicando el PID, la fórmula de decodificación aplicada y el rango de valores observados durante las sesiones de prueba.

\begin{table}[!htbp]
\caption{PIDs del modo 0x01 validados en el banco de ensayo.}
\label{tab:pids_validados}
\centering
\renewcommand{\arraystretch}{1.2}
\begin{tabular}{|c|l|l|c|}
\hline
\textbf{PID} & \textbf{Parámetro} & \textbf{Fórmula (A, B = bytes de respuesta)} & \textbf{Rango observado} \\
\hline
\texttt{0x0C} & RPM del motor & $((A \times 256) + B) / 4$ & 800 -- 6000\,rpm \\
\texttt{0x0D} & Velocidad & $A$ & 0 -- 255\,km/h \\
\texttt{0x05} & Temp. refrigerante & $A - 40$ & 15 -- 95\,°C \\
\texttt{0x0F} & Temp. aire admisión & $A - 40$ & 15 -- 45\,°C \\
\texttt{0x0A} & Presión combustible & $A \times 3$ & 240 -- 360\,kPa \\
\texttt{0x11} & Posición acelerador & $A \times 100 / 255$ & 0 -- 100\,\% \\
\texttt{0x04} & Carga calculada motor & $A \times 100 / 255$ & 10 -- 85\,\% \\
\texttt{0x5E} & Consumo combustible & $((A \times 256) + B) / 20$ & 0,4 -- 8,5\,L/h \\
\texttt{0x42} & Tensión de batería & $((A \times 256) + B) / 1000$ & 12,4 -- 14,8\,V \\
\hline
\end{tabular}
\end{table}

La respuesta VIN se validó con una cadena de 17 caracteres ASCII, verificando que la secuencia ISO-TP multi-frame (FF + FC + CF $\times$ 2) se completaba correctamente en el 100\% de los intentos realizados con el bus en modo determinista. El VIN reconstruido en la herramienta Python coincidió en todos los casos con la cadena configurada en el simulador Arduino.

El ciclo de gestión de DTCs se validó íntegramente: lectura de lista vacía, inyección de los tres DTCs del conjunto (\texttt{P0300}, \texttt{P0171}, \texttt{P0420}) mediante la interrupción hardware del pin D4, lectura de la lista con los códigos presentes, borrado y confirmación de lista vacía. La codificación J2012 de los DTCs fue correcta en todos los casos.

\section{Métricas de rendimiento de la comunicación}
\label{sec:resultados_rendimiento}

Se midió la latencia round-trip extremo a extremo de una consulta completa, desde el envío del comando JSON por la aplicación móvil hasta la recepción de la respuesta decodificada. Las marcas de tiempo de transmisión (\texttt{ble\_tx}) y de recepción (\texttt{ble\_rx}) registradas por la propia aplicación durante una sesión real sobre el banco de pruebas permiten emparejar cada petición con su respuesta; sobre las 38 transacciones de la sesión, el script \texttt{scripts/latency\_from\_csv.py} calcula los estadísticos recogidos en la tabla~\ref{tab:latencias}.

\begin{table}[H]
\caption{Latencia round-trip extremo a extremo medida sobre 38 transacciones reales.}
\label{tab:latencias}
\centering
\renewcommand{\arraystretch}{1.2}
\begin{tabular}{|l|c|}
\hline
\textbf{Estadístico} & \textbf{Latencia (ms)} \\
\hline
Mínimo        & 57 \\
Mediana       & 100 \\
Media         & 128 \\
Percentil 95  & 387 \\
Máximo        & 548 \\
\hline
\end{tabular}
\end{table}

La latencia dominante la introduce la capa BLE (las operaciones \textbf{Write} y \textbf{Notify}), siendo la contribución de CAN+ISO-TP despreciable a las velocidades de bus empleadas. La mediana se mantiene en torno a 100\,ms, coherente con el carácter interactivo de la herramienta. El percentil 95 más elevado (387\,ms) corresponde a las operaciones con respuesta multi-frame de mayor tamaño (\texttt{probe\_pids} y \texttt{snapshot}), mientras que las consultas individuales como \texttt{uds\_read\_did} se mantienen en una mediana de 98\,ms.

% Cadencia real medida con scripts/db_metrics.py sobre las sesiones de monitorización
% continua de diagnostics.db (intervalo entre muestras consecutivas de cada PID).
En el modo de monitorización continua, el periodo de ciclo real medido escala de forma lineal con el número de PIDs solicitados concurrentemente, debido al coste acumulado de las transacciones ISO-TP secuenciales en el bus CAN. Cuando el cliente solicita un conjunto reducido de 7 PIDs (configurado con un intervalo objetivo de 500\,ms), el sistema estabiliza su periodo de refresco con una mediana de 586\,ms y una media de 591\,ms, reflejando un overhead de procesamiento e I/O de aproximadamente 80--100\,ms respecto al temporizador ideal. A medida que el volumen de PIDs asciende a 18 y 24 solicitudes por ciclo, la naturaleza síncrona y bloqueante del escaneo expande el periodo de ciclo a medianas de 703\,ms y 816\,ms, respectivamente. En todos los escenarios concurrentes analizados bajo bus determinista, la dispersión estadística se mantuvo notablemente acotada (con rangos intercuartílicos inferiores a 25\,ms), garantizando una tasa de actualización altamente predecible y libre de pérdidas de muestras o saturación en el hilo de transmisión BLE.

\begin{table}[H]
\caption{Cadencia real de la monitorización continua medida sobre la base de datos SQLite (intervalo medido entre ráfagas consecutivas de actualización).}
\label{tab:cadencia}
\centering
\renewcommand{\arraystretch}{1.2}
\begin{tabular}{|c|c|c|c|}
\hline
\textbf{PIDs por ciclo} & \textbf{Periodo mediana (ms)} & \textbf{Media (ms)} & \textbf{P10 -- P90 (ms)} \\
\hline
7  & 586 & 591 & 571 -- 631 \\
18 & 703 & 706 & 692 -- 713 \\
24 & 816 & 821 & 806 -- 838 \\
\hline
\end{tabular}
\end{table}

\section{Comportamiento ante condiciones de bus realistas y errores}
\label{sec:resultados_ruido}

Se evaluó el comportamiento del sistema con los mecanismos opcionales de variabilidad del simulador activos (\texttt{ADD\_NOISE} y \texttt{BROADCAST\_ENABLE}) y ante respuestas negativas (NRC) de la ECU.

Los resultados más relevantes de estas pruebas son:

\begin{itemize}
    \item \textbf{Tramas de difusión}: Con \texttt{BROADCAST\_ENABLE} activo, las tramas no solicitadas (identificadores \texttt{0x280}, \texttt{0x320} y \texttt{0x3D0}) fueron ignoradas por la pila \texttt{can-isotp}, que solo entrega los mensajes dirigidos a la dirección de respuesta de la ECU (\texttt{0x7E8}). En ningún caso una trama de difusión se interpretó como respuesta válida a una petición.

    \item \textbf{Ruido en los sensores}: Con \texttt{ADD\_NOISE} activo, los valores de telemetría presentaron el \textit{jitter} esperado dentro de sus rangos físicos, sin afectar a la correcta decodificación de las respuestas ni a la estabilidad de la monitorización continua.

    \item \textbf{Respuestas negativas UDS}: Las respuestas NRC (por ejemplo, \texttt{0x22} al leer un DID propietario fuera de la sesión extendida) fueron detectadas y registradas correctamente. El hilo de monitorización omite la muestra afectada y prosigue con el siguiente PID del ciclo, sin bloquear la sesión.

    \item \textbf{Robustez del transporte}: El timeout de recepción de 5\,segundos y el reensamblado automático de \texttt{can-isotp} absorbieron la latencia de las transmisiones multi-frame sin generar falsos errores, manteniendo la sesión estable durante toda la prueba.
\end{itemize}

La Figura~\ref{fig:res_consolas} muestra la traza de ejecución durante una de estas pruebas: la consola del simulador Arduino, que emite las tramas de difusión y el ruido inyectado en los sensores, y la consola de la Raspberry Pi, donde la pila \texttt{can-isotp} descarta las tramas ajenas y decodifica únicamente las respuestas dirigidas a la dirección de la ECU.

\begin{figure}[H]
\centering
\begin{minipage}[t]{0.48\textwidth}
\centering

\subcaption{Consola del simulador Arduino.}
\label{fig:res_consola_ard}
\end{minipage}\hfill
\begin{minipage}[t]{0.48\textwidth}
\centering

\subcaption{Consola de la Raspberry Pi.}
\label{fig:res_consola_pi}
\end{minipage}
\caption{Traza de ejecución bajo condiciones de bus realistas: consola del simulador Arduino emitiendo tramas de difusión (\texttt{[BC TX]}) e inyectando DTCs por interrupción hardware (a) y consola de la Raspberry Pi decodificando respuestas OBD-II y UDS (b).}
\label{fig:res_consolas}
\end{figure}

\section{Interfaz de la aplicación móvil}
\label{sec:resultados_app}

A continuación se recogen las capturas de las distintas pantallas de la aplicación móvil obtenidas durante las pruebas en el vehículo real, que ilustran el resultado final de la interfaz de usuario sobre las cinco pestañas de navegación y el flujo de conexión.

\begin{figure}[H]
\centering
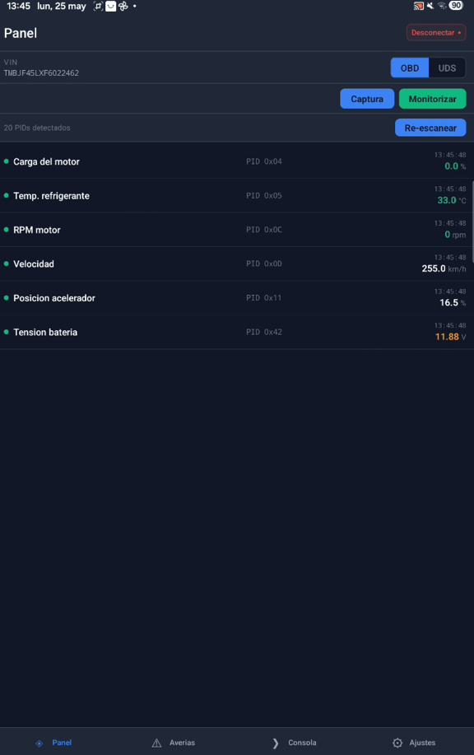
[picture p48: documentation/Ilustraciones/datos_real.png]
%
\hspace{0.04\textwidth}%
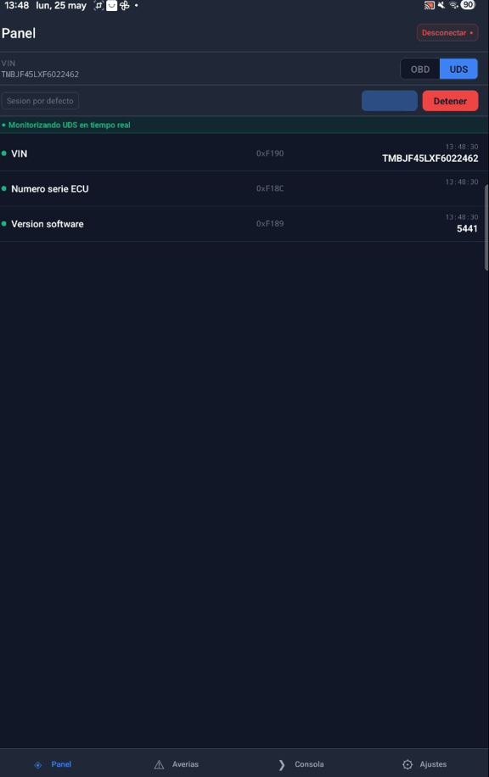
[picture p49: documentation/Ilustraciones/uds_real.png]

\caption{Pantalla \textit{Panel}: telemetría en tiempo real (izquierda) y pestaña UDS con control de sesión y lectura de DIDs (derecha).}
\label{fig:res_app_panel}
\end{figure}

\begin{figure}[H]
\centering
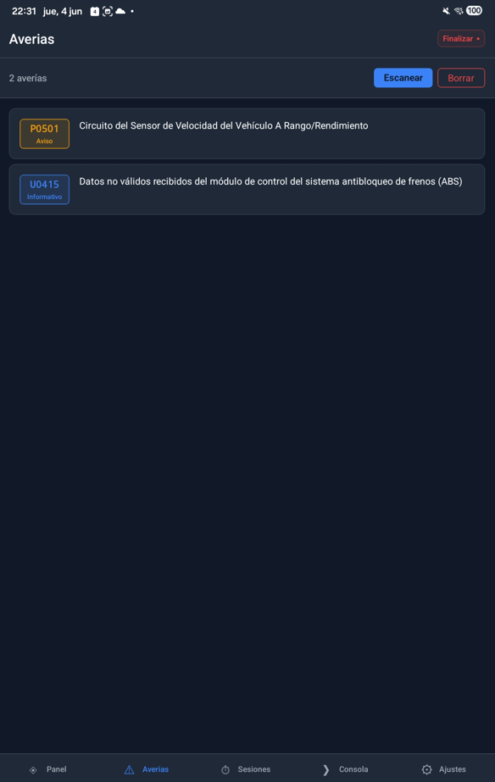
[picture p50: documentation/Ilustraciones/dtcs_real.png]
%
\hspace{0.04\textwidth}%
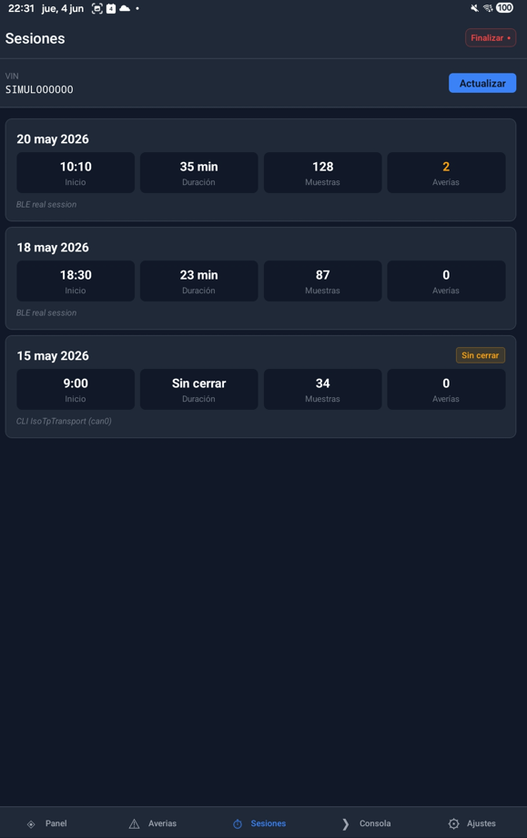
[picture p51: documentation/Ilustraciones/sesiones_sim.png]

\caption{Pantallas \textit{Averías} (izquierda), con la lista de DTCs leídos de la ECU, y \textit{Sesiones} (derecha), con el historial de sesiones almacenado en SQLite.}
\label{fig:res_app_dtc_sesiones}
\end{figure}

\begin{figure}[H]
\centering
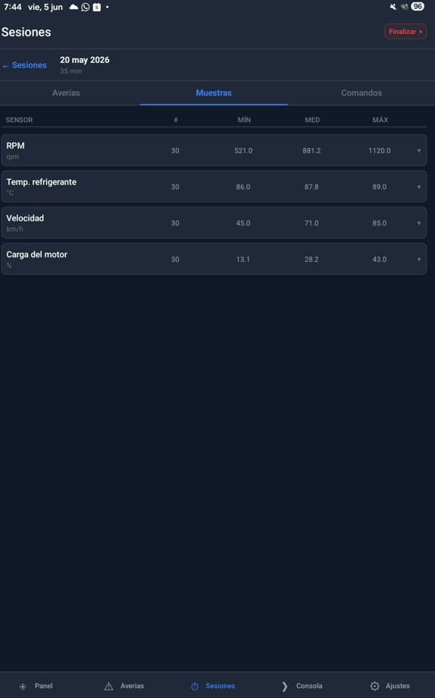
[picture p52: documentation/Ilustraciones/sesion_detalle.png]
%
\hspace{0.04\textwidth}%
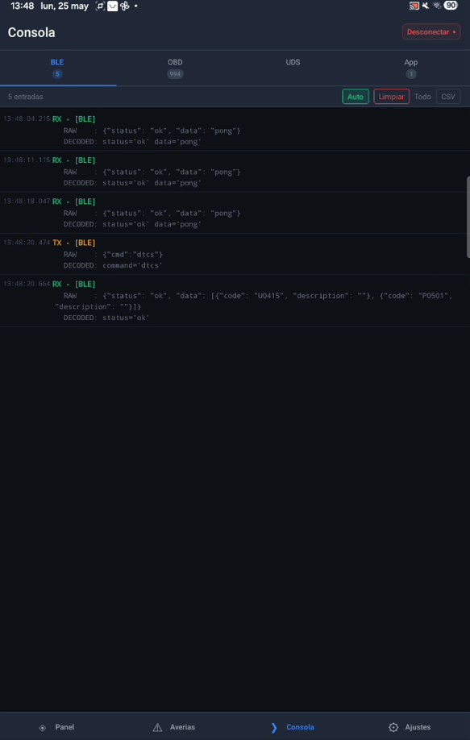
[picture p53: documentation/Ilustraciones/logs_real.png]

\caption{Detalle de una sesión con las muestras agrupadas por sensor (izquierda) y pantalla \textit{Consola} con el envío de comandos JSON y el registro de comunicación BLE (derecha).}
\label{fig:res_app_detalle_consola}
\end{figure}

\begin{figure}[H]
\centering
%
\hspace{0.04\textwidth}%
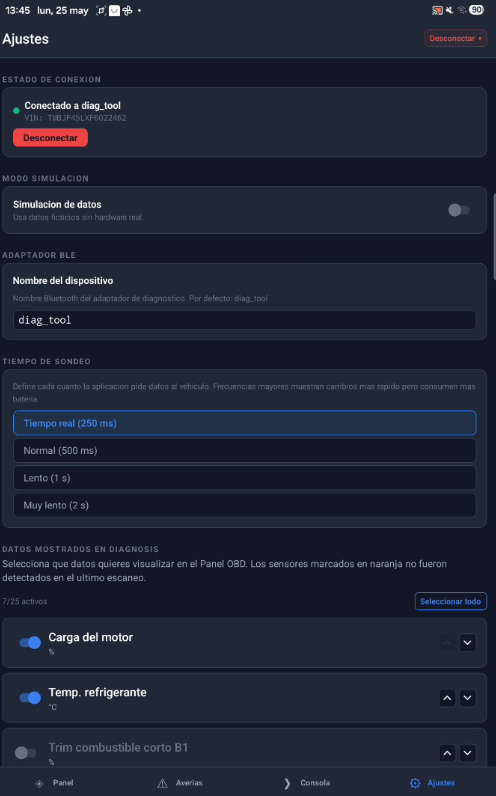
[picture p54: documentation/Ilustraciones/ajustes.png]

\caption{Pantalla \textit{Conexión} (izquierda), con la gestión del enlace BLE, y pantalla \textit{Ajustes} (derecha), con el modo de simulación y preferencias.}
\label{fig:res_app_ajustes_conexion}
\end{figure}

% TODO - revisar y redactar
\section{Grado de consecución de los objetivos}
\label{sec:resultados_objetivos}

La tabla~\ref{tab:objetivos} recoge el grado de consecución de cada uno de los objetivos específicos definidos en la Sección~\ref{sec:objetivos}, evaluado sobre la base de los resultados de las pruebas de integración.

\begin{table}[H]
\caption{Evaluación del grado de consecución de los objetivos específicos.}
\label{tab:objetivos}
\centering
\renewcommand{\arraystretch}{1.2}
\begin{tabular}{|l|p{7cm}|c|}
\hline
\textbf{Obj.} & \textbf{Indicador de consecución} & \textbf{Resultado} \\
\hline
O1 & Pila ISO-TP + OBD-II modos 0x01/03/04/09 operativa & Completo \\
O2 & Simulador Arduino responde a los 4 modos con datos realistas & Completo \\
O3 & Servicios UDS (0x10/0x22) y mecanismos opcionales de ruido/difusión & Completo \\
O4 & Servidor BLE GATT con NUS operativo en Raspberry Pi & Completo \\
O5 & App React Native Android/iOS con 5 pantallas funcionales & Completo \\
O6 & Logging SQLite con sesiones, muestras y comandos & Completo \\
\hline
\end{tabular}
\end{table}

Los seis objetivos específicos se han alcanzado en su totalidad. La validación sobre vehículo real (Sección~\ref{sec:resultados_vehiculo_real}) confirmó la compatibilidad del sistema con ECUs de producción, completando la cadena de validación desde el banco de ensayo controlado hasta un entorno vehicular real.
