gorkaftv1/TFT-CAN-BLE-system/(commit log)

2026-05-02 chore: inicializacion del proyecto
    Estructura base: arduino-sim, src (Python OBD2) y documentation (LaTeX).
    Incluye .gitignore, .gitattributes y CI workflow para compilacion LaTeX.
2026-05-02 feat(mobile-app): BLE device scan list, 4-tab logs, write-with-response fix
2026-05-08 feat(arduino-sim): add CAN noise, background traffic and DTC fault interrupt
    [ecu_protocol.h, ecu_sim.ino]
2026-05-18 feat(arduino): UDS session control, ReadDataByIdentifier, clean console output
2026-05-18 feat(pi): UDS CLI commands, transport logging, Spanish PID/DID names, per-PID snapshot error handling
    [ecu_sim.ino]
2026-05-23 docs: WIP reestructuración memoria — nuevos capítulos, figuras, refs y TODOs
2026-05-23 fix(server): renombrar banner a diag_tool, debug en _on_write para diagnosticar BLE
2026-05-23 feat(src): probe_pids command, smart snapshot cache, reduce transport timeout 5s->2s
2026-05-23 feat(mobile-app): probe_pids — auto-scan al conectar, boton re-scan en Settings, monitor filtra PIDs soportados
2026-05-24 feat(mobile-app): solicitar permisos BLE al iniciar la app
2026-05-24 feat(arduino-sim): ADD_NOISE flag, SIM_MODE_FULL/BASIC, LOG_LEVEL guards
2026-05-27 feat(ecu-sim): complete OBD-II PID coverage, fix bitmasks, reorganize noise config
    [ecu_protocol.h, ecu_sim.ino]
2026-05-27 feat(src): DTC persistence, probe_pids bitmap+poll, NRC blacklist, auth idempotent, disconnect cmd, DB path hardcoded, README
2026-05-28 feat(sessions): batch BLE sample loading, expandable sensor cards, dashboard UI
2026-05-29 docs: fix BibTeX, fix PID count 23->25, rewrite alcance section
2026-05-29 fix(ecu-sim): restore DTC fault interrupt on pin 6, fix ignition debounce
    [ecu_protocol.h, ecu_sim.ino]
2026-05-29 docs(arduino-sim): add README
2026-05-29 docs(src): update README with ISO-TP frame examples, UDS bytes, NRC, DTC encoding, session_dtcs, dtcs table
2026-05-29 fix(ecu-sim): filter release-bounce on buttons, raise debounce to 800ms
    [ecu_protocol.h, ecu_sim.ino]
2026-05-29 fix(ecu-sim): move buttons to D5/D4, FALLING+hysteresis debounce, add throttle ramp sim
    [ecu_protocol.h, ecu_sim.ino]
2026-06-06 fix(ble): log snapshot PID reads and UDS DID reads to commands table
2026-06-06 (documentation): casos de uso app, recorrido de pantallas y prueba Opel Astra K
2026-06-06 revert(ble): do not log OBD snapshot PID reads to commands table
2026-06-08 fix(ble): no responder a heartbeat_ack para no romper el emparejamiento peticion-respuesta
2026-06-08 feat(scripts): db_metrics.py para extraer metricas de diagnostics.db
2026-06-08 fix(ble): correlacion robusta peticion-respuesta y fin de logs/errores espurios
2026-06-08 fix(dashboard): detener el sondeo UDS al desconectar o desmontar
2026-06-08 fix(logs): buffer a 20000 entradas y no truncar el RAW de BLE RX
2026-06-08 fix(build): usar el JDK de JAVA_HOME en build-android.ps1
2026-06-08 docs: fragmentos de codigo, algoritmos, resumen y resultados cuantitativos, e includegraphics directo de figuras
2026-06-08 docs(bib): autor en las entradas de estandares ISO/SAE
2026-06-09 fix: corregir bug DTC phantom en Mode 03 y comentarios encoding UDS DIDs
    [ecu_protocol.h, ecu_sim.ino]
2026-06-09 refactor: implementar capa UDS y corregir bugs de auditoría (snapshot NRC, dead code)
2026-06-09 docs: revisión final de capítulos, evidencias de pruebas, script de latencia y figuras
    [diag_completo_2026-06-08T09-19-18.csv]
2026-06-10 fix: ecu_sim voltage clamp, log guards, CAN broadcast
    [ecu_sim.ino]
2026-06-10 feat(sessions): paginate session samples with offset to recover full history past 100
